CoachChuckFF/ESP32_Motor_Breakout_Board/LDI Stepper board pinout.xlsx

Sheet: ESP32DEVKITC
Connection | Pin | ^^ CHIP ^^ | Pin | Connection | Connection | Pin | 2nd | \/\/ CHIP \/\/ | 2nd | Pin | Connection | Notes
3.3V BUS | 3.3V |  | GND | GND | N/C | GPIO6 | FLASH SCK |  |  | 5V | 5VDC BUS
RESET | EN |  | GPIO23 | SPI | N/C | GPIO7 | FLASH D0 |  | FLASH CMD | GPIO11 | N/C
Nextion RX | GPIO36 |  | GPIO22 | Nextion TX | N/C | GPIO8 | FLASH D1 |  | FLASH D3 | GPIO10 | N/C
Motor 2 Endstop | GPIO39 |  | GPIO1 | Console Serial / TX0 |  | GPIO15 | HSPI SS |  | FLASH D2 | GPIO9 | N/C
Motor 1 Endstop | GPIO34 |  | GPIO3 | Console Serial / RX0 | Motor 0 Enc A | GPIO2 | ADC12 |  | HSPI MOSI | GPIO13 | Motor 2 Step
Motor 0 Endstop | GPIO35 |  | GPIO21 | Motor 1 Enc B | BOOT / NC | GPIO0 | BOOT |  |  | GND | GND
Motor 2 Direction | GPIO32 |  | GND | GND | Motor 0 Enc B | GPIO4 |  |  | HSPI MISO | GPIO12 | Motor 2 Enc A
Motor 1 Step | GPIO33 |  | GPIO19 | SPI | DMX + | GPIO16 |  |  | HSPI SCK | GPIO14 | Motor 2 Enc B
Motor 1 Direction | GPIO25 |  | GPIO18 | Motor 2 Step | Motor 1 Enc A | GPIO17 |  |  | ADC17 | GPIO27 | Motor 0 Direction
Motor 0 Step | GPIO26 |  | GPIO5 | SPI | SPI | GPIO5 | VSPI MISO |  | ADC19 | GPIO26 | Motor 0 Step
Motor 0 Direction | GPIO27 |  | GPIO17 | Motor 1 Enc A | SPI | GPIO18 | VSPI SCK |  | ADC18 | GPIO25 | Motor 1 Direction
Motor 2 Enc B | GPIO14 |  | GPIO16 | DMX + | SPI | GPIO19 | VSPI SS |  | ADC5 | GPIO33 | Motor 1 Step
Motor 2 Enc A | GPIO12 |  | GPIO4 | Motor 0 Enc B | GND | GND |  |  | ADC4 | GPIO32 | Motor 2 Direction
GND | GND |  | GPIO0 | BOOT / NC | Motor 1 Enc B | GPIO21 |  |  | ADC7 | GPIO35 | Motor 0 Endstop | Input Only
Motor 2 Step | GPIO13 |  | GPIO2 | Motor 0 Enc A | Console Serial / RX0 | GPIO3 | RX0 |  | ADC6 | GPIO34 | Motor 1 Endstop | Input Only
N/C | GPIO9 |  | GPIO15 | 0 | Console Serial / TX0 | GPIO1 | RX0 |  | ADC3 | GPIO39 | Motor 2 Endstop | Input Only
N/C | GPIO10 |  | GPIO8 | N/C | Nextion TX | GPIO22 |  |  | ADC0 | GPIO36 | Nextion RX | Input Only
N/C | GPIO11 |  | GPIO7 | N/C | SPI | GPIO23 | VSPI MOSI |  |  | EN | RESET
5VDC BUS | 5V |  | GPIO6 | N/C | GND | GND |  |  |  | 3.3V | 3.3V BUS

Sheet: HEADERS
Header # | Pin # | Desc | Type | Connects to
1 | 1 | Power In | PCB Mount Screw Term | LM7805 Vin
 | 2 | GND |  | GND
2 | 1 | GND | 4-pin JST | GPIO16
 | 2 | DMX - |  | GND
 | 3 | DMX + |  | GND
3 | 1 | Nextion 5VDC | 4-pin JST | LM7805 Vout
 | 2 | Nextion TX |  | GPIO22
 | 3 | Nextion RX |  | GPIO36
 | 4 | GND |  | GND
4 | 1 | SPI MISO | 4-pin Female 2.5mm pin header | GPIO5
 | 2 | SPI SCK |  | GPIO18
 | 3 | SPI MOSI |  | GPIO23
 | 4 | SPI SS |  | GPIO19
5 | 1 | Motor 0 3.3V+ | PCB Mount Screw Term | 3.3V
 | 2 | Motor 0 Step |  | GPIO26
 | 3 | Motor 0 Direction |  | GPIO27
6 | 1 | Motor 1 3.3V+ | PCB Mount Screw Term | 3.3V
 | 2 | Motor 1 Step |  | GPIO33
 | 3 | Motor 1 Direction |  | GPIO25
7 | 1 | Motor 2 3.3V+ | PCB Mount Screw Term | 3.3V
 | 2 | Motor 2 Step |  | GPIO13
 | 3 | Motor 2 Direction |  | GPIO32
8 | 1 | Motor 0 Endstop 5VDC+ | 3-pin JST | 5V
 | 2 | Motor 0 Endstop Signal |  | GPIO35
 | 3 | GND |  | GND
9 | 1 | Motor 1 Endstop 5VDC+ | 3-pin JST | 5V
 | 2 | Motor 2 Endstop Signal |  | GPIO34
 | 3 | GND |  | GND
10 | 1 | Motor 2 Endstop 5VDC+ | 3-pin JST | 5V
 | 2 | Motor 2 Endstop Signal |  | GPIO39
 | 3 | GND |  | GND
11 | 1 | Motor Encoder 0 5VDC+ | 4-pin JST | 5V
 | 2 | Motor 0 Encoder Signal A |  | GPIO2
 | 3 | Motor 0 Encoder Signal B |  | GPIO4
 | 4 | GND |  | GND
12 | 1 | Motor Encoder 1 5VDC+ | 4-pin JST | 5V
 | 2 | Motor 1 Encoder Signal A |  | GPIO17
 | 3 | Motor 1 Encoder Signal B |  | GPIO21
 | 4 | GND |  | GND
13 | 1 | Motor Encoder 2 5VDC+ | 4-pin JST | 5V
 | 2 | Motor 2 Encoder Signal A |  | GPIO12
 | 3 | Motor 2 Encoder Signal B |  | GPIO14
 | 4 | GND
