CoachChuckFF/ESP32_Motor_Breakout_Board/bom.xlsx

# | Quantity | Part Number | Manufacturer Part Number | Description | Customer Reference | Backorder | Unit Price | Extended Price
1 | 10 | S7017-ND | PPTC191LFBN-RC | CONN HEADER FEMALE 19POS.1" TIN |  | 0 | 1.026 | 10.26
2 | 3 | 945-3013-ND | REC5A-2405SW/H2 | DC DC CONVERTER 5V 5W |  | 0 | 14.39 | 43.17
3 | 5 | 1727-3502-ND | 74LVC4245ADB,112 | IC TRANSCVR TRI-ST DL 24SSOP |  | 0 | 1.05 | 5.25
4 | 10 | S7002-ND | PPTC041LFBN-RC | CONN HEADER FEMALE 4POS .1" TIN |  | 0 | 0.424 | 4.24
5 | 5 | 277-1721-ND | 1984617 | CONN TERM BLOCK T/H 2POS 3.5MM |  | 0 | 0.43 | 2.15
6 | 15 | 455-2248-ND | B3B-XH-A(LF)(SN) | CONN HEADER XH TOP 3POS 2.5MM |  | 0 | 0.181 | 2.72
7 | 10 | 709-1047-1-ND | 302R29W102KV4E | CAP CER 1000PF 3KV X7R 1808 |  | 0 | 0.221 | 2.21
8 | 10 | 493-1663-ND | UHE2A470MPD | CAP ALUM 47UF 20% 100V RADIAL |  | 0 | 0.364 | 3.64
9 | 20 | 490-3340-1-ND | GRM219R60J106KE19D | CAP CER 10UF 6.3V X5R 0805 |  | 0 | 0.105 | 2.10
10 | 10 | 490-1666-1-ND | GRM21BR71H104KA01L | CAP CER 0.1UF 50V X7R 0805 |  | 0 | 0.146 | 1.46
11 | 5 | MAX485CSA+-ND | MAX485CSA+ | IC TXRX RS485/RS422 LOWPWR 8SOIC |  | 0 | 1.96 | 9.80
12 | 30 | 277-1860-ND | 1984633 | CONN TERM BLOCK T/H 4POS 3.5MM |  | 0 | 0.817 | 24.51
13 | 1000 | 311-0.0ARCT-ND | RC0805JR-070RL | RES SMD 0 OHM JUMPER 1/8W 0805 |  | 0 | 0.00321 | 3.21
14 | 25 | 455-2249-ND | B4B-XH-A(LF)(SN) | CONN HEADER XH TOP 4POS 2.5MM |  | 0 | 0.194 | 4.85
15 | 25 | 335-1148-ND | RM3X10MM 2701 | MACHINE SCREW PAN PHILLIPS M3 |  | 0 | 0.4232 | 10.58
16 | 25 | 36-24434-ND | 24434 | HEX STANDOFF M3 ALUMINUM 12MM |  | 0 | 0.431 | 10.78
