CoachChuckFF/ESP32_Motor_Breakout_Board/stepper_breakout/main.pdf

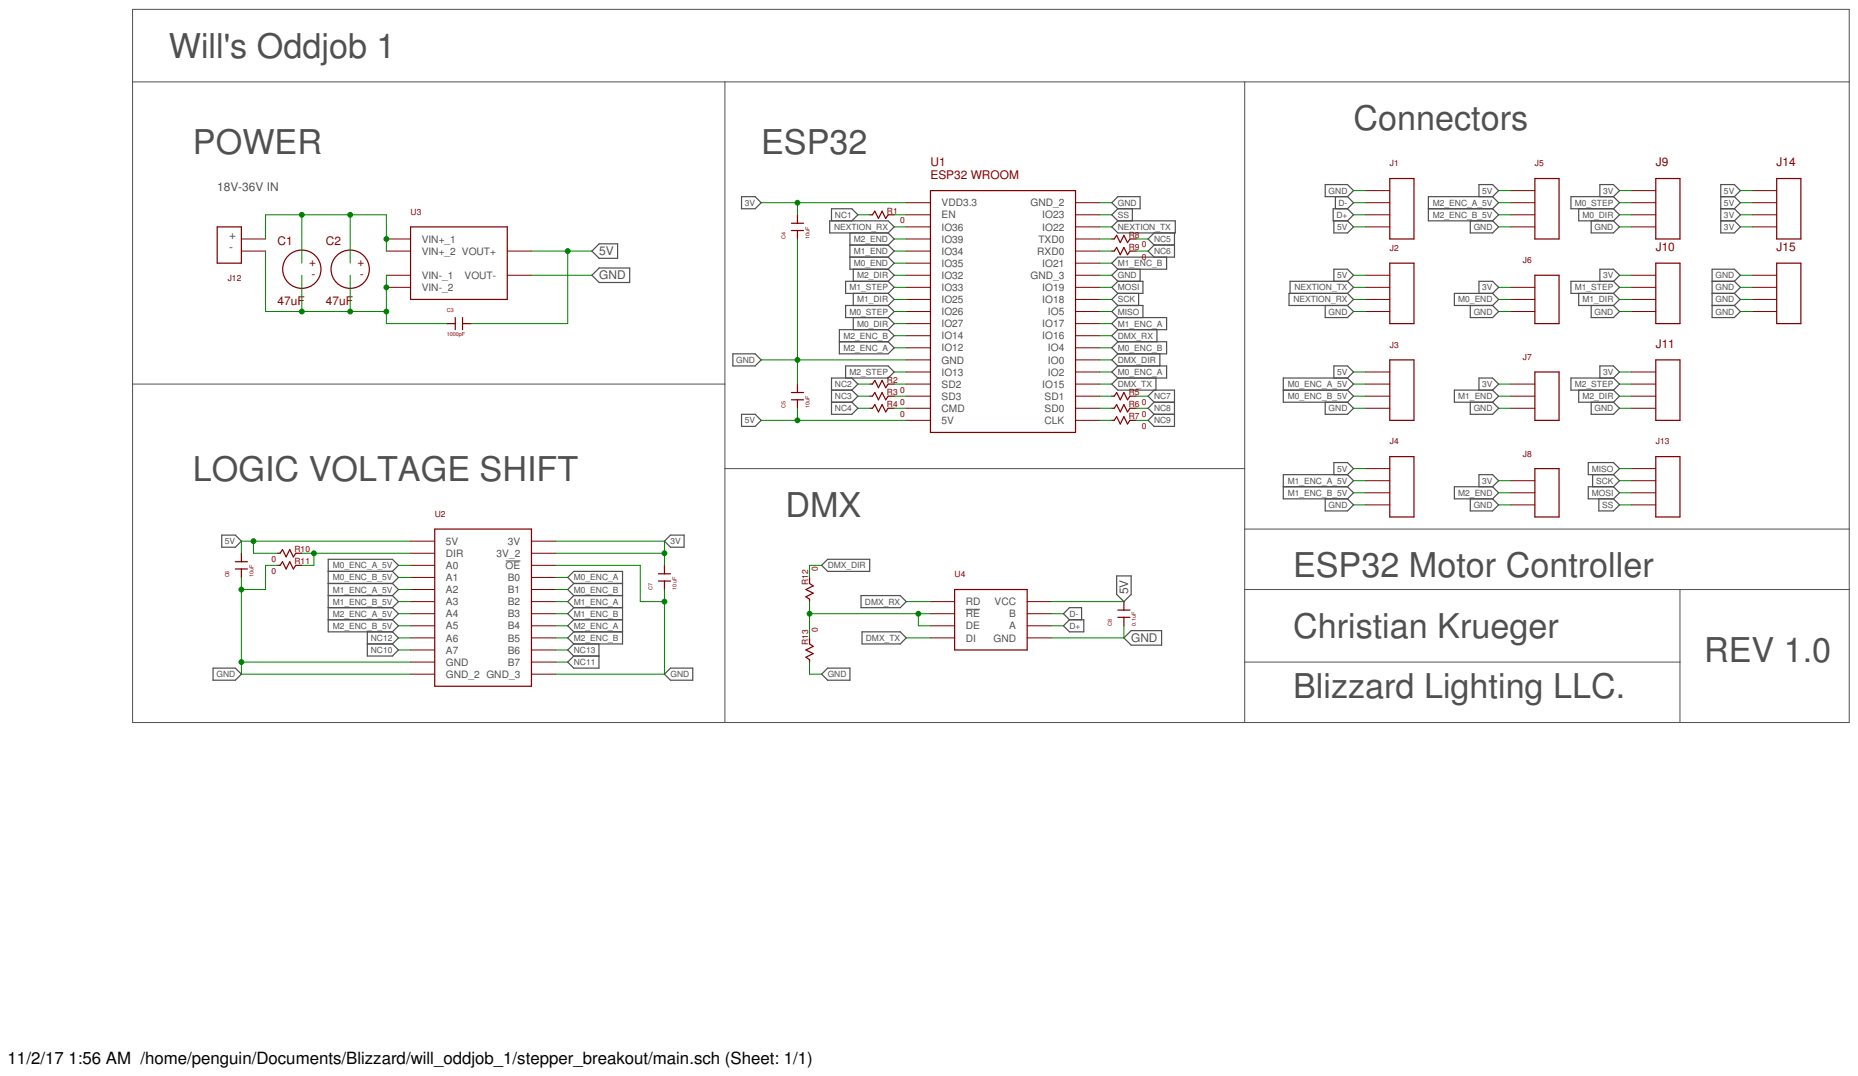
[picture p1: page 1]

VIN+_1 VIN+_2 VIN-_1 VIN-_2 VOUT- VOUT+

GND GND

M1_ENC_A_5V
M1_ENC_B_5V
Blizzard Lighting LLC. ESP32 Motor Controller
REV 1.0 Christian Krueger

11/2/17 1:56 AM /home/penguin/Documents/Blizzard/will_oddjob_1/stepper_breakout/main.sch (Sheet: 1/1)
