CoachChuckFF/ESP32_Motor_Breakout_Board/stepper_breakout/main_board.pdf

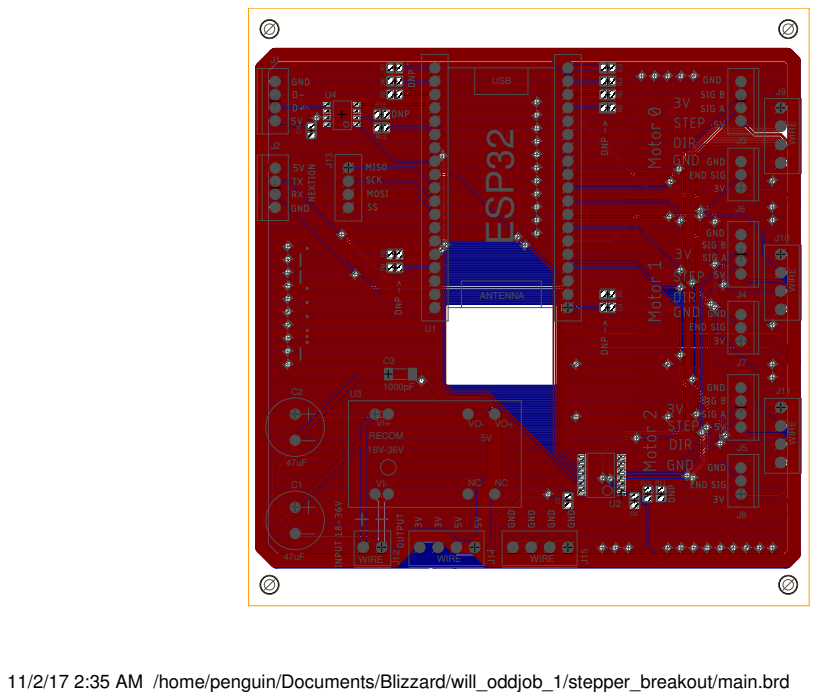
[picture p2: page 1]

11/2/17 2:35 AM /home/penguin/Documents/Blizzard/will_oddjob_1/stepper_breakout/main.brd
