CoachChuckFF/ESP32_Motor_Breakout_Board/stepper_breakout/main.brd

## EAGLE design stepper_breakout/main.brd (2017-11-02)

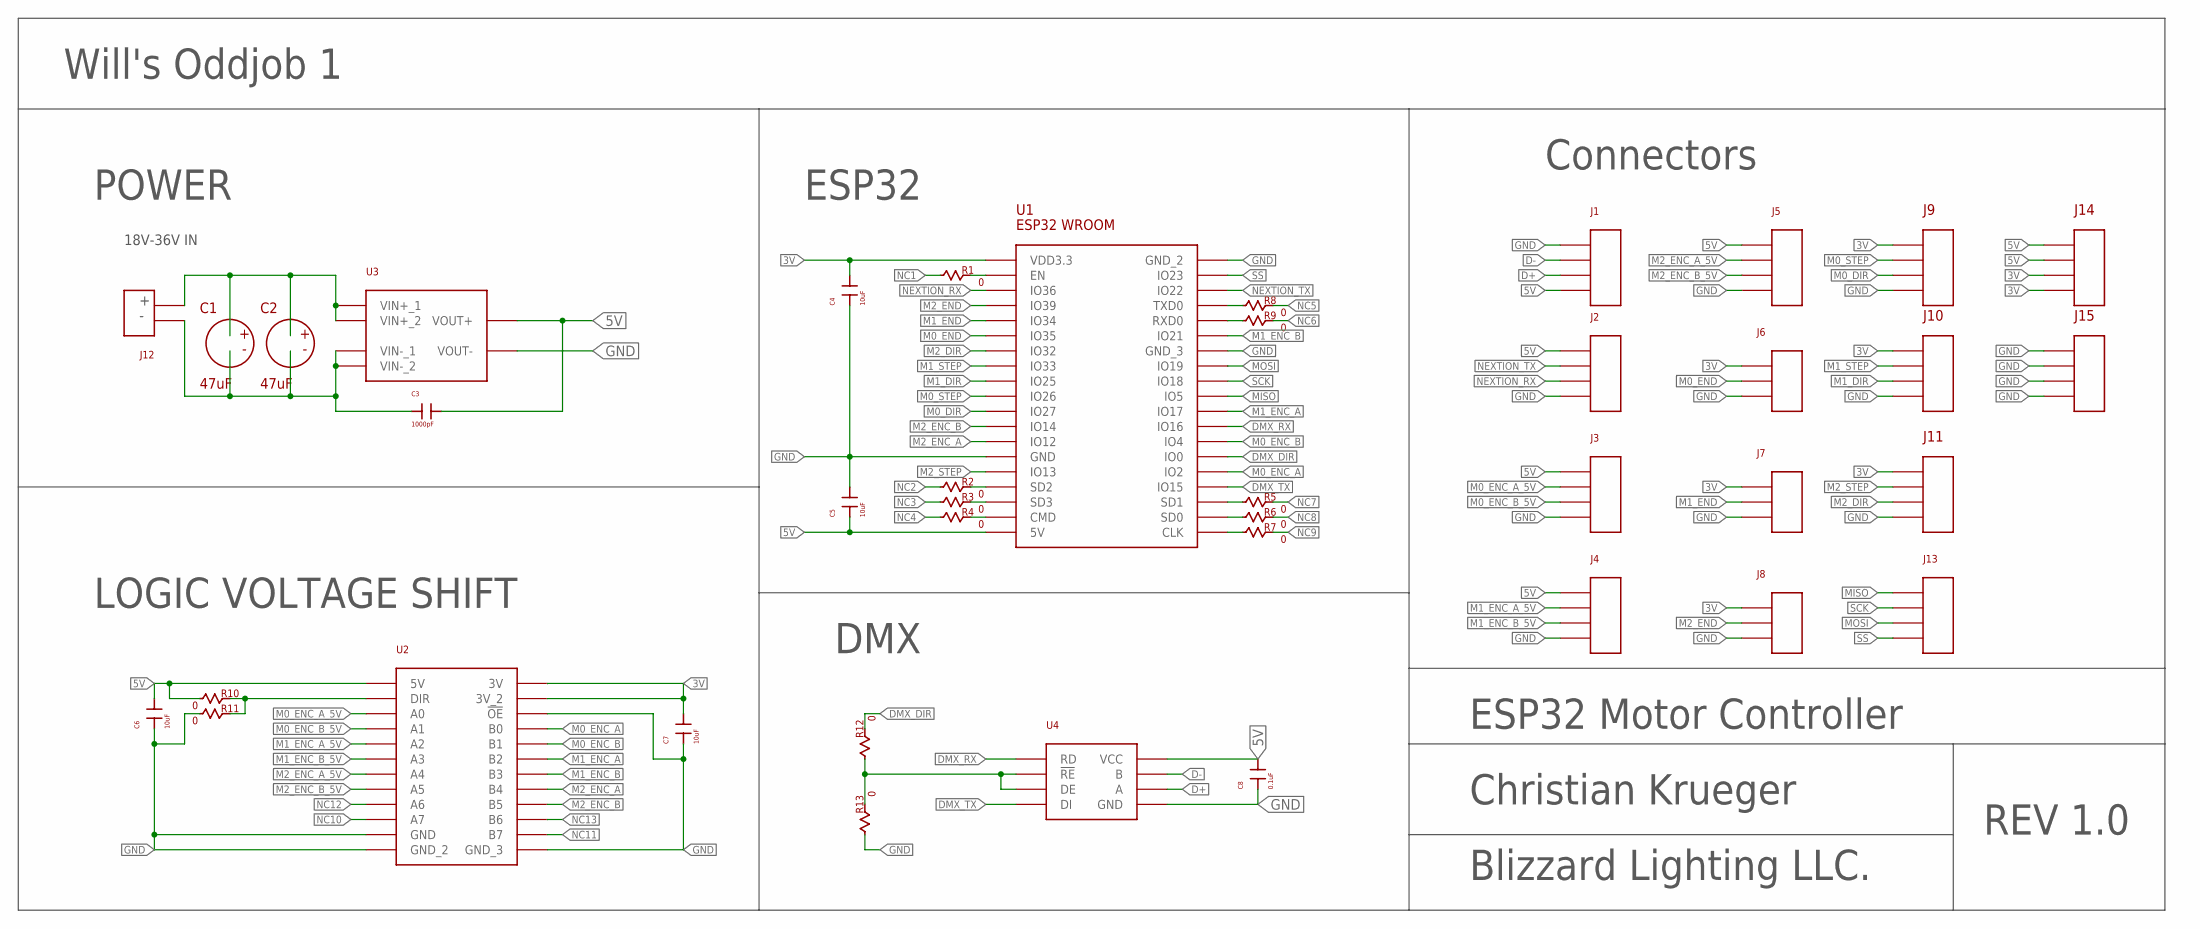
[picture p3: schematic main.sch]

Parts:
C1, C2: 47uF; TH_CAP_PKG
C3: 1000pF; 1808_PKG
C4, C5, C6, C7: 10uF; 0805_PKG
C8: 0.1uF; 0805_PKG
J1, J2, J3, J4, J5: XH_4POS_DEV; XH_4POS_PKG
J6, J7, J8: XH_3POS_DEV; XH_3POS_PKG
J9, J10, J11, J14, J15: 4_PIN_SCREW_3.5MM_DEV; 4_PIN_SCREW_3.5MM_PKG
J12: 2_PIN_SCREW_3.5MM_DEV; 2_PIN_SCREW_3.5MM_PKG
J13: 4_PIN_2.54MM_PKG
R1, R2, R3, R4, R5, R6, R7, R8, R9, R10, R11, R12, R13: 0; 0805_PKG
U1: ESP32_WROOM_BREAKOUT_DEV; ESP_WROOM_BREAKOUT_PKG
U2: 8_CHANNEL_LEVEL_SHIFTER; 8_LEVEL_SHIFTER_PKG
U3: 5V_SWITCHING_POWER_DEV; 5V_SWITCHING_POWER_PKG
U4: MAX_485_DEV; MAX_485_PKG

Connections:
3V: C4.P$2, C7.P$2, J6.P$1 (1), J7.P$1 (1), J8.P$1 (1), J9.1, J10.1, J11.1, J14.3, J14.4, U1.VDD3.3, U2.3V, U2.3V_2
5V: C3.P$2, C5.P$1, C6.P$2, C8.P$2, J1.P$4, J2.P$1, J3.P$1, J4.P$1, J5.P$1, J14.1, J14.2, R10.P$1, U1.5V, U2.5V, U3.VOUT+, U4.P$8 (VCC)
D+: J1.P$3, U4.P$6 (A)
D-: J1.P$2, U4.P$7 (B)
DMX_DIR: R12.P$2, U1.IO0
DMX_RX: U1.IO16, U4.P$1 (RD)
DMX_TX: U1.IO15, U4.P$4 (DI)
GND: C4.P$1, C5.P$2, C6.P$1, C7.P$1, C8.P$1, J1.P$1, J2.P$4, J3.P$4, J4.P$4, J5.P$4, J6.P$3 (3), J7.P$3 (3), J8.P$3 (3), J9.4, J10.4, J11.4, J15.1, J15.2, J15.3, J15.4, R11.P$1, R13.P$1, U1.GND, U1.GND_2, U1.GND_3, U2.!OE, U2.GND, U2.GND_2, U2.GND_3, U3.VOUT-, U4.P$5 (GND)
M0_DIR: J9.3, U1.IO27
M0_ENC_A: U1.IO2, U2.B0
M0_ENC_A_5V: J3.P$2, U2.A0
M0_ENC_B: U1.IO4, U2.B1
M0_ENC_B_5V: J3.P$3, U2.A1
M0_END: J6.P$2 (2), U1.IO35
M0_STEP: J9.2, U1.IO26
M1_DIR: J10.3, U1.IO25
M1_ENC_A: U1.IO17, U2.B2
M1_ENC_A_5V: J4.P$2, U2.A2
M1_ENC_B: U1.IO21, U2.B3
M1_ENC_B_5V: J4.P$3, U2.A3
M1_END: J7.P$2 (2), U1.IO34
M1_STEP: J10.2, U1.IO33
M2_DIR: J11.3, U1.IO32
M2_ENC_A: U1.IO12, U2.B4
M2_ENC_A_5V: J5.P$2, U2.A4
M2_ENC_B: U1.IO14, U2.B5
M2_ENC_B_5V: J5.P$3, U2.A5
M2_END: J8.P$2 (2), U1.IO39
M2_STEP: J11.2, U1.IO13
MISO: J13.1, U1.IO5
MOSI: J13.3, U1.IO19
unnamed: C1.P$1, C2.P$1, J12.P$2 (2), U3.VIN+_1, U3.VIN+_2
unnamed: C1.P$2, C2.P$2, C3.P$1, J12.P$1 (1), U3.VIN-_1, U3.VIN-_2
unnamed: R1.P$2, U1.EN
unnamed: R12.P$1, R13.P$2, U4.P$2 (!RE), U4.P$3 (DE)
unnamed: R2.P$2, U1.SD2
unnamed: R3.P$2, U1.SD3
unnamed: R4.P$2, U1.CMD
unnamed: R10.P$2, R11.P$2, U2.DIR
unnamed: R7.P$1, U1.CLK
unnamed: R6.P$1, U1.SD0
unnamed: R5.P$1, U1.SD1
unnamed: R8.P$1, U1.TXD0
unnamed: R9.P$1, U1.RXD0
NC1: R1.P$1
NC2: R2.P$1
NC3: R3.P$1
NC4: R4.P$1
NC5: R8.P$2
NC6: R9.P$2
NC7: R5.P$2
NC8: R6.P$2
NC9: R7.P$2
NC10: U2.A7
NC11: U2.B7
NC12: U2.A6
NC13: U2.B6
NEXTION_RX: J2.P$3, U1.IO36
NEXTION_TX: J2.P$2, U1.IO22
SCK: J13.2, U1.IO18
SS: J13.4, U1.IO23

Notes on the sheet:
18V-36V IN
POWER
ESP32
LOGIC VOLTAGE SHIFT
DMX
Connectors
Will's Oddjob 1
REV 1.0
Christian Krueger
Blizzard Lighting LLC.
ESP32 Motor Controller

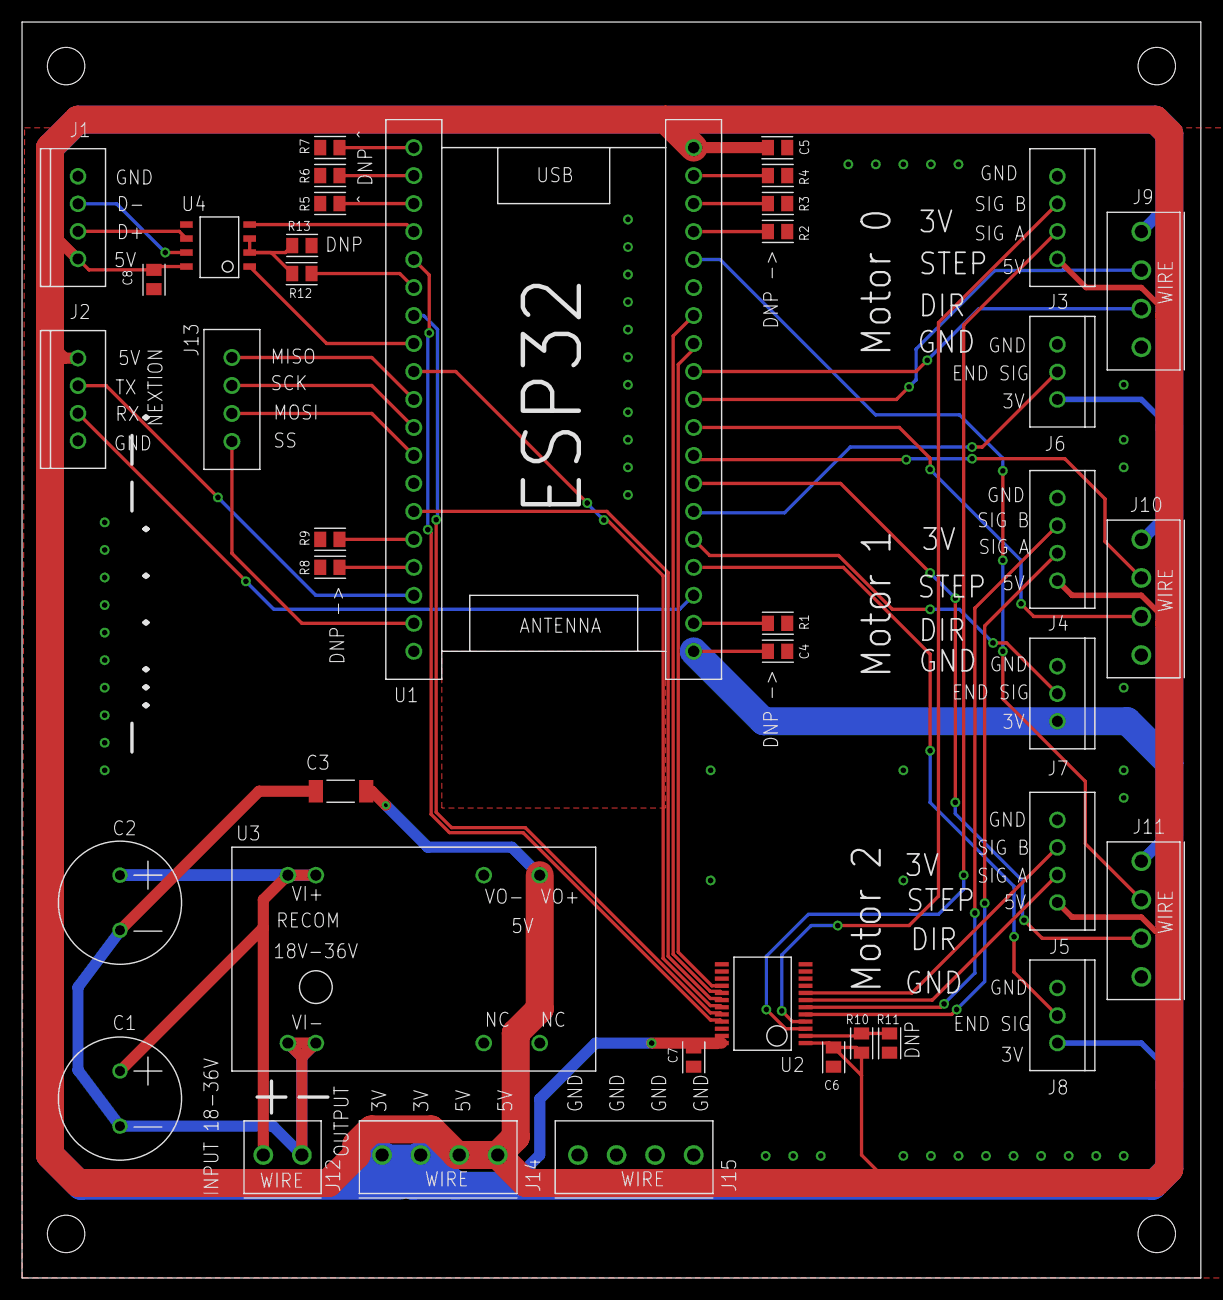
[picture p4: board main.brd from above]

Board: 2 copper layers, 107.0 x 114.0 mm, 40 parts (0 on the bottom side), 48 nets.
