CoachChuckFF/ESP32_Motor_Breakout_Board/(commit log)

2017-11-02 sch almost done
    [LDI Stepper board pinout.xlsx, main.sch]
2017-11-02 rev1 done
    [main.brd, main.sch]
